jcaf/RPI-AXSenior-Tarjeta1-Motor/TARJETADEMO1/PCB1/Raspberry-Pi-3-Altium-Template-master/README.md

# Raspberry-Pi-3-Altium-Template

This Project should simplifiy the design process of modules for raspberry pi 2 and 3, model B.
It uses the 40 pin GPIO connector to access the rpi GPIOs. The dimensions of the board are based on the image below which comes from the raspberry pi developers. 

Thanks to Matheus for his feedback. The design is now tested a few times and was produced successfully.

Here is a preview on how it looks in 3D, on top of an raspberry pi.

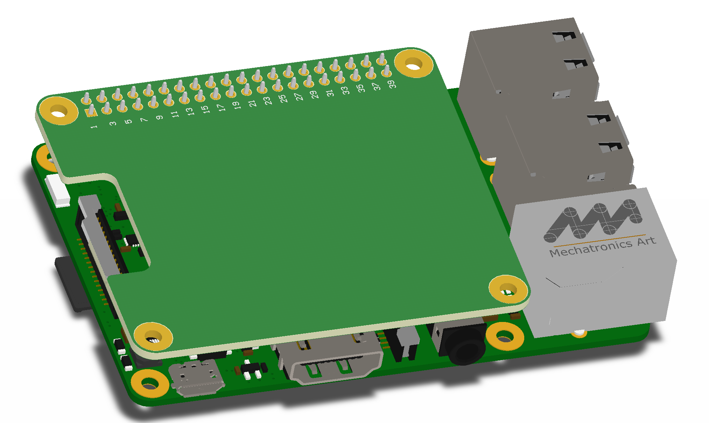
[picture p1: TARJETADEMO1/PCB1/Raspberry-Pi-3-Altium-Template-master/images/3d.png]
PCB in 3D view


The original drawing of the raspberry dimensions.

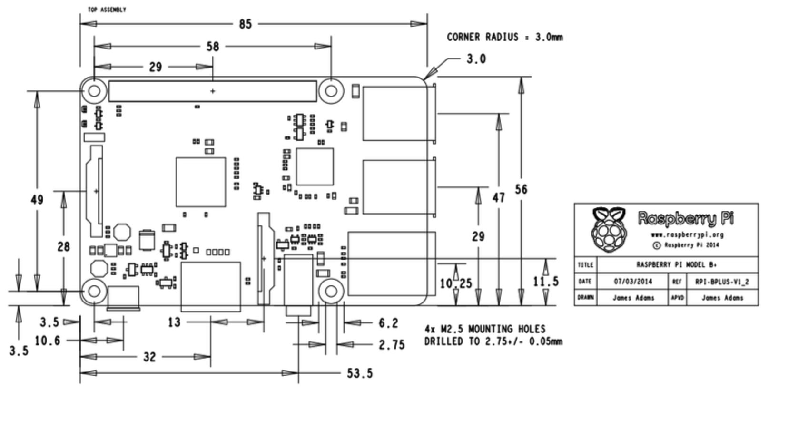
[picture p2: TARJETADEMO1/PCB1/Raspberry-Pi-3-Altium-Template-master/images/drawing1.png]
Original drawing of model B


Dimensions from template pcb, made by altiums draftsman

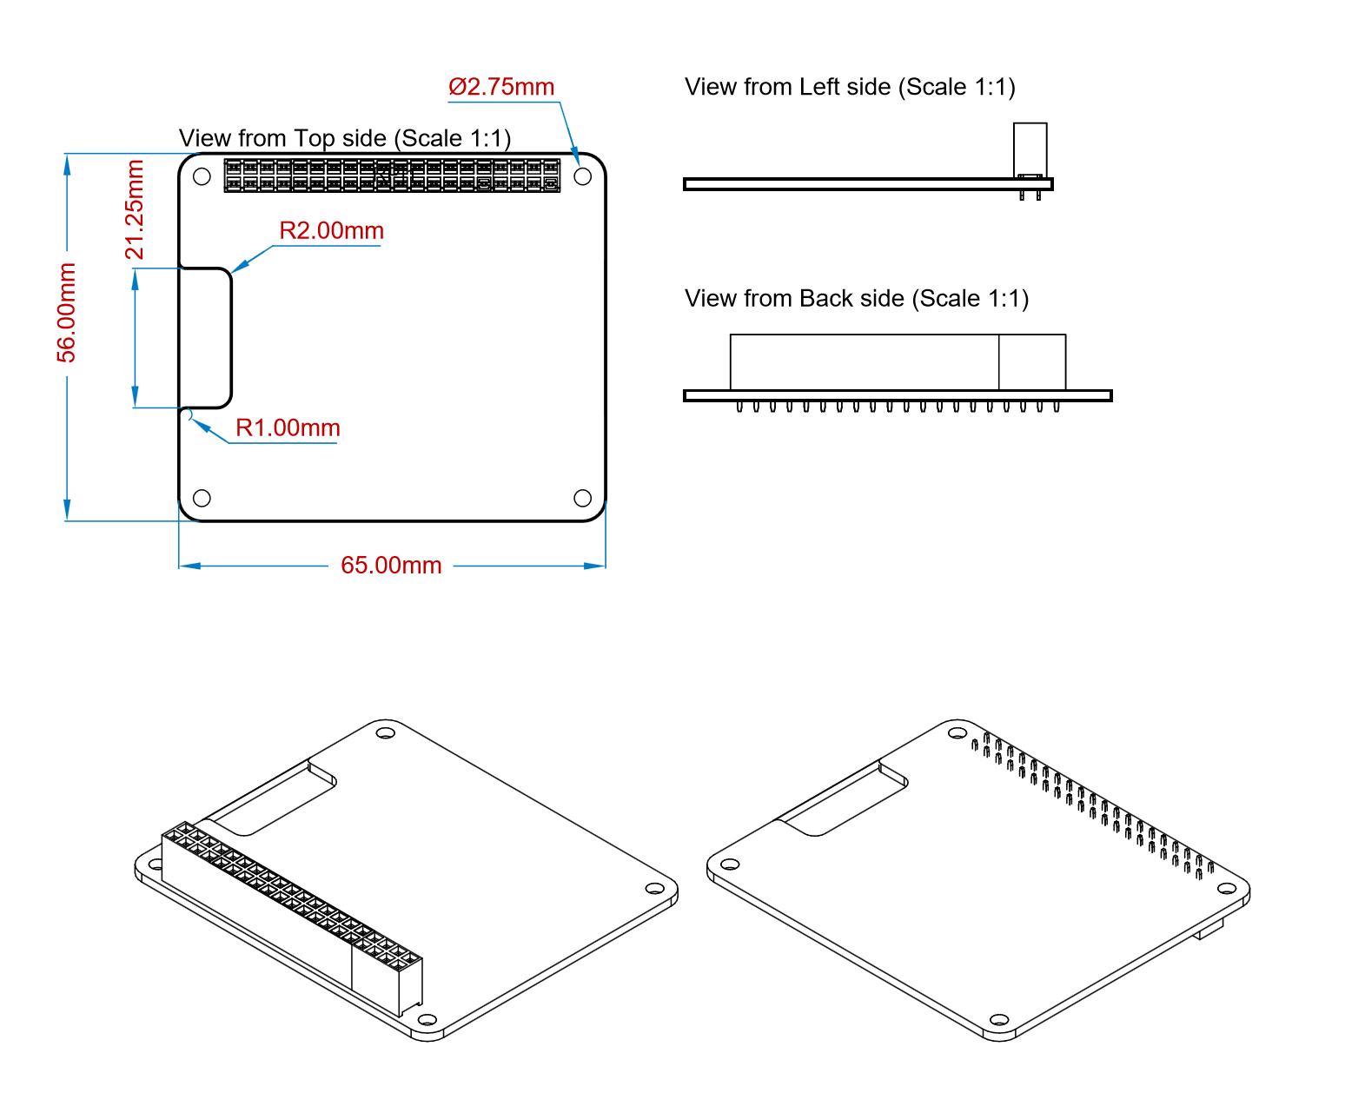
[picture p3: TARJETADEMO1/PCB1/Raspberry-Pi-3-Altium-Template-master/images/drawing2.png]
draftsman dimensioning


kindly
# Nils
