jcaf/RPI-AXSenior-Tarjeta1-Motor/TARJETADEMO1/INFO/Bi-Directional MOSFET Voltage Level Converter 3.3V to 5V_files/mosfet-level-converter-2.jpg

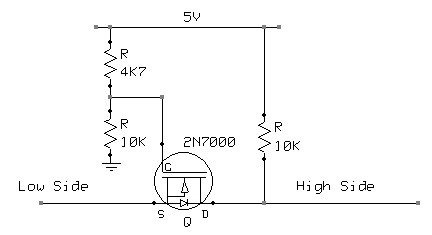
TARJETADEMO1/INFO/Bi-Directional MOSFET Voltage Level Converter 3.3V to 5V_files/mosfet-level-converter-2.jpg
