jcaf/RPI-AXSenior-Tarjeta1-Motor/TARJETADEMO1/INFO/ZMPT101B-Datasheet.jpg

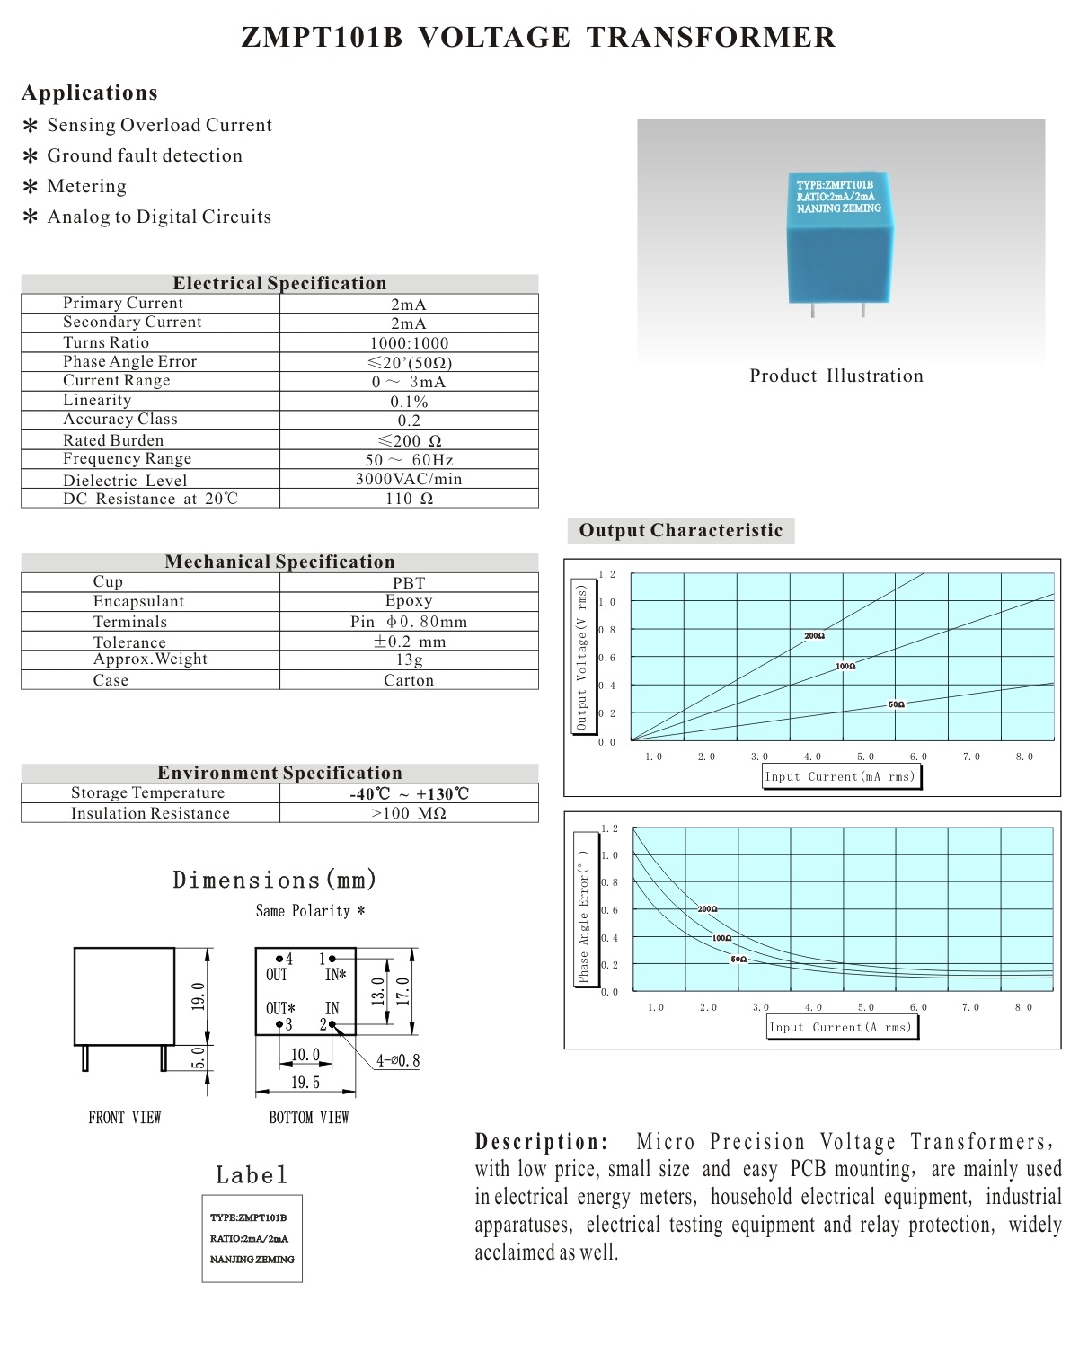
TARJETADEMO1/INFO/ZMPT101B-Datasheet.jpg
