jcaf/RPI-AXSenior-Tarjeta1-Motor/TARJETADEMO1/PCB1/Prototipo1/BOM-Prototipo1.xlsx

Comment | Description | Designator | Footprint | LibRef | Quantity
0.01uF | SMD_CHIP_CAP_CER_0603_TO_1206 | C1, C3, C5, C7 | SMD_CHIP_CAP_CER_0603_TO_1206 | SMD_CHIP_CAP_CER_0603_TO_1206 | 4
0.22uF | SMD_CHIP_CAP_CER_0603_TO_1206 | C2, C4, C6, C38 | SMD_CHIP_CAP_CER_0603_TO_1206 | SMD_CHIP_CAP_CER_0603_TO_1206 | 4
0.1uF | SMD_CHIP_CAP_CER_0603_TO_1206 | C8, C9, C10, C17, C19, C20, C21, C24, C25, C27, C28, C29, C30 | SMD_CHIP_CAP_CER_0603_TO_1206 | SMD_CHIP_CAP_CER_0603_TO_1206 | 13
68nF | 820p 1kV Y5P | C11 | Cap-Disk-D5.5-R5.08 | Cer Disc HV 820p 1kV | 1
68nF | SMD_CHIP_CAP_CER_0603_TO_1206 | C12 | SMD_CHIP_CAP_CER_0603_TO_1206 | SMD_CHIP_CAP_CER_0603_TO_1206 | 1
390nF | 820p 1kV Y5P | C13 | Cap-Disk-D5.5-R5.08 | Cer Disc HV 820p 1kV | 1
180nF | 820p 1kV Y5P | C14 | Cap-Disk-D5.5-R5.08 | Cer Disc HV 820p 1kV | 1
390nF | SMD_CHIP_CAP_CER_0603_TO_1206 | C15 | SMD_CHIP_CAP_CER_0603_TO_1206 | SMD_CHIP_CAP_CER_0603_TO_1206 | 1
180nF | SMD_CHIP_CAP_CER_0603_TO_1206 | C16 | SMD_CHIP_CAP_CER_0603_TO_1206 | SMD_CHIP_CAP_CER_0603_TO_1206 | 1
0.1uF | SMD_CHIP_CAP_CER_1206 | C18, C26 | SMD_CHIP_Cap_Cer_1206 | SMD_CHIP_CAP_CER_1206 | 2
VJ0603A150FXACW1BC |  | C22, C23 | CAPC1608X95X40ML15T15 | CMP-2006-01814-1 | 2
470uF/10V Tant. | T495X477K010ATE100 | C31 | SMD_2917 | SMD_2917 | 1
10u | 35V | C33 | El-d5-h11-F2.54 | 10u-35V | 1
1u | 35V | C34 | El-d5-h11-F2.54 | 10u-35V | 1
470uF 25V | 25V | C35, C36 | El-d8-h14-F3.81 | 470u-25V | 2
0.022uF | SMD_CHIP_CAP_CER_0603_TO_1206 | C36 | SMD_CHIP_CAP_CER_0603_TO_1206 | SMD_CHIP_CAP_CER_0603_TO_1206 | 1
470uF/25V | 25V | C37 | El-d8-h14-F3.81 | 470u-25V | 1
B550C-13-F | Schottky Barrier Rectifier , 50 V, 5 A, -55 to 150 degC, 2-Pin SMD, RoHS, Tape and Reel | D1 | DIOD-SMC-2-A_V | CMP-2000-05906-1 | 1
1N5819 | 40V 1A | D3, D4 | DO-41-300 | 1N5819 | 2
DS3231 16-SOIC | SOIC, 16-Leads, Body 10.5x7.5mm (max), Pitch 1.27mm, IPC Medium Density | DS1 | SOIC127P1030X265-16N | DS3231 | 1
RTD2-Wire-Select |  | H1 | J1x3 | H-1x3 | 1
H-1x2 |  | H2, H14 | J1x2 | H-1x2 | 2
H-1x3 |  | H3, H4, H5, H7, H8, H9, H10, H15 | J1x3 | H-1x3 | 8
H-1x6 |  | H6, H12 | J1x6 | H-1x6 | 2
H-1x4 |  | H11, H13 | J1x4 | H-1x4 | 2
MKDS 1,5 2-5,08 | PCB terminal block, nominal current: 17.5 A, nom. voltage: 400 V, pitch: 5.08 mm | H16, H17 | MKDS 1,5 2-5,08 | MKDS 1,5 2-5,08 | 2
LMV321RILT | Integrated Circuit | IC1 | SOT95P280X145-5N | LMV321RILT | 1
D Connector 9 | Receptacle Assembly, 9 Position, Right Angle | J1 | DB9-HEMBRA | D Connector 9 | 1
BLM31PG601SN1L | Chip Ferrite Bead Inductor | L1, L2 | SMD_CHIP_FERRITE_1206 | CHIP_FERRITE_BEAD_INDUCTOR_1206 | 2
FB 1206 600 ohms 100MHZ 600R 1.5A | Chip Ferrite Bead Inductor | L3 | SMD_CHIP_FERRITE_1206 | CHIP_FERRITE_BEAD_INDUCTOR_1206 | 1
33uH 3.2A 1280 | Shielded SMD Power Inductor, 33 uH, +/- 20%, -40 to 125 degC, 2-Pin SMD, RoHS, Tape and Reel | L4 | BOUR-SRR1280-2_V | CMP-2000-07148-1 | 1
Led | 5mm | LD1 | Led d5mm | Led-5mm | 1
MH Pin - 5.5Pad - 3.3drill | MH Pin - 5.5Pad - 3.3drill | MH1, MH2, MH3 | MH Pin - 5.5Pad - 3.3drill | MH Pin - 5.5Pad - 3.3drill | 3
B.desmont.2Pins | Header, 2-Pin | P1, P4, P7 | KF2EDGV/R-2P | Header 2 | 3
EspadinHembra | Header, 2-Pin | P2 | HDR1X2 | Header 2 | 1
ZMPT101B MODULE | Header, 4-Pin | P3 | ZMPT101B_MODULE | Header 4 | 1
RTD PT100 | Header, 4-Pin | P5 | KF2EDGV/R-4P | Header 4 | 1
RTD_Output | Header, 2-Pin | P6 | HDR1X2 | Header 2 | 1
Header 6 | Header, 6-Pin | P8 | KF2EDGV/R-6P | Header 6 | 1
CR2032_Holder | CR2032_Holder | PB1 | CR2032 | CR2032_Holder | 1
2N3904 | NPN General Purpose Amplifier | Q1, Q2 | TO-92A-Pitch100MILS | 2N3904 | 2
220 ohm | SMD_CHIP_RESISTOR_0603_TO_1206 | R1, R3, R4, R5 | SMD_CHIP_RESISTOR_0603_TO_1206 | SMD_CHIP_RESISTOR_0603_TO_1206 | 4
10K | SMD_CHIP_RESISTOR_0603_TO_1206 | R2, R27 | SMD_CHIP_RESISTOR_0603_TO_1206 | SMD_CHIP_RESISTOR_0603_TO_1206 | 2
1K | SMD_CHIP_RESISTOR_1206 | R6 | SMD_CHIP_RESISTOR_1206 | SMD_CHIP_RESISTOR_1206 | 1
220 ohm | SMD_CHIP_RESISTOR_1206 | R7, R33 | SMD_CHIP_RESISTOR_1206 | SMD_CHIP_RESISTOR_1206 | 2
25K | SMD_CHIP_RESISTOR_0603_TO_1206 | R8, R10, R12, R13 | SMD_CHIP_RESISTOR_0603_TO_1206 | SMD_CHIP_RESISTOR_0603_TO_1206 | 4
25K | SMD_CHIP_RESISTOR_1206 | R9 | SMD_CHIP_RESISTOR_1206 | SMD_CHIP_RESISTOR_1206 | 1
2.5K | SMD_CHIP_RESISTOR_0603_TO_1206 | R11 | SMD_CHIP_RESISTOR_0603_TO_1206 | SMD_CHIP_RESISTOR_0603_TO_1206 | 1
1K | SMD_CHIP_RESISTOR_0603_TO_1206 | R14, R22, R24, R28, R29, R31, R32, R36, R37 | SMD_CHIP_RESISTOR_0603_TO_1206 | SMD_CHIP_RESISTOR_0603_TO_1206 | 9
100K | SMD_CHIP_RESISTOR_0603_TO_1206 | R15, R16 | SMD_CHIP_RESISTOR_0603_TO_1206 | SMD_CHIP_RESISTOR_0603_TO_1206 | 2
17.4K | SMD_CHIP_RESISTOR_0603_TO_1206 | R17 | SMD_CHIP_RESISTOR_0603_TO_1206 | SMD_CHIP_RESISTOR_0603_TO_1206 | 1
107K | SMD_CHIP_RESISTOR_0603_TO_1206 | R18 | SMD_CHIP_RESISTOR_0603_TO_1206 | SMD_CHIP_RESISTOR_0603_TO_1206 | 1
49.9K | SMD_CHIP_RESISTOR_0603_TO_1206 | R19 | SMD_CHIP_RESISTOR_0603_TO_1206 | SMD_CHIP_RESISTOR_0603_TO_1206 | 1
3.09K | SMD_CHIP_RESISTOR_0603_TO_1206 | R20 | SMD_CHIP_RESISTOR_0603_TO_1206 | SMD_CHIP_RESISTOR_0603_TO_1206 | 1
20K | SMD_CHIP_RESISTOR_1206 | R21 | SMD_CHIP_RESISTOR_1206 | SMD_CHIP_RESISTOR_1206 | 1
100 Ohm | SMD_CHIP_RESISTOR_0603_TO_1206 | R23 | SMD_CHIP_RESISTOR_0603_TO_1206 | SMD_CHIP_RESISTOR_0603_TO_1206 | 1
2.2K | SMD_CHIP_RESISTOR_0603_TO_1206 | R25, R26 | SMD_CHIP_RESISTOR_0603_TO_1206 | SMD_CHIP_RESISTOR_0603_TO_1206 | 2
2K | SMD_CHIP_RESISTOR_0603_TO_1206 | R30 | SMD_CHIP_RESISTOR_0603_TO_1206 | SMD_CHIP_RESISTOR_0603_TO_1206 | 1
1 Ohm | 0.25W 5% 250V | R34, R35 | R0.25-400 | R-0.25W | 2
RAS | AC-120V 15A DC-14V 20A 30V 15A /0.36W | RA1, RA2 | Rele RAS | Relay RAS | 2
RPI GPIO Connector | GPIO Header for Raspberry Pi A+/B+/Pi 2/Pi 3 - 2x20 | RPI1 | rpi | rpi connector | 1
ADS1115IDGST | 16-Bit ADC with Integrated Multiplexer, PGA, Comparator, Oscillator, and Reference, -40 to 125 degC, 10-pin SOP (DGS10), Green (RoHS & no Sb/Br) | U1 | TI-DGS10_L | CMP-0003-00378-2 | 1
LMV324IDR | Quad Low-Voltage Rail-to-Rail Output Operational Amplifier, 2.7 to 5.5 V, -40 to 125 degC, 14-Pin SOIC (D), Green (RoHS & no Sb/Br), Tape and Reel | U2 | D0014A_V | CMP-1685-00010-1 | 1
LM385Z-2.5/NOPB | Micropower Voltage Reference Diode, 3-pin TO-92, Pb-Free | U3 | Z03A | CMP-0074-00017-2 | 1
ATmega328P-PU | 8-bit AVR Microcontroller, 32KB Flash, 1KB EEPROM, 2KB SRAM, 28-pin PDIP, Industrial Grade (-40°C to 85°C) | U4 | 28P3 | CMP-0095-00013-2 | 1
MAX3232CSE+T | Low-Power, True RS-232 Transceivers Using Four 0.1 uF External Capacitor, up to 1 Mbps, 3.0 to 5.5 V, 0 to 70 degC, 16-Pin SOIC (S16+1), RoHS, Tape and Reel | U5 | MAXM-S16+1_M | CMP-2000-06662-1 | 1
7805 |  | U6 | TO 220_DISIPADOR_HORIZONTAL_2 | 7805 | 1
LM2596S-5.0/NOPB | SIMPLE SWITCHER® Power Converter 150 KHz 3A Step-Down Voltage Regulator, 5-pin TO-263, Pb-Free | U7 | KTT0005B_M | CMP-0069-00269-3 | 1
CRYSTAL_PTH_16MHz | CRYSTAL_PTH_16MHz | Y1 | Crystal PTH HC49LT, THT, 16MHz | CRYSTAL_PTH_16MHz | 1
