jcaf/RPI-AXSenior-Tarjeta1-Motor/TARJETADEMO1/INFO/Problems with a two-diode 3.3V -> 5V level shifting circuit - Electrical Engineering Stack Exchange_files/6oxsM.png

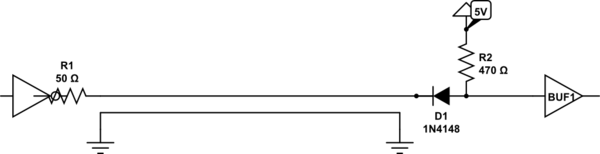
TARJETADEMO1/INFO/Problems with a two-diode 3.3V -> 5V level shifting circuit - Electrical Engineering Stack Exchange_files/6oxsM.png
