jcaf/RPI-AXSenior-Tarjeta1-Motor/TARJETADEMO1/PCB1/Prototipo1/Artes-Serigrafia/bottom solder.pdf

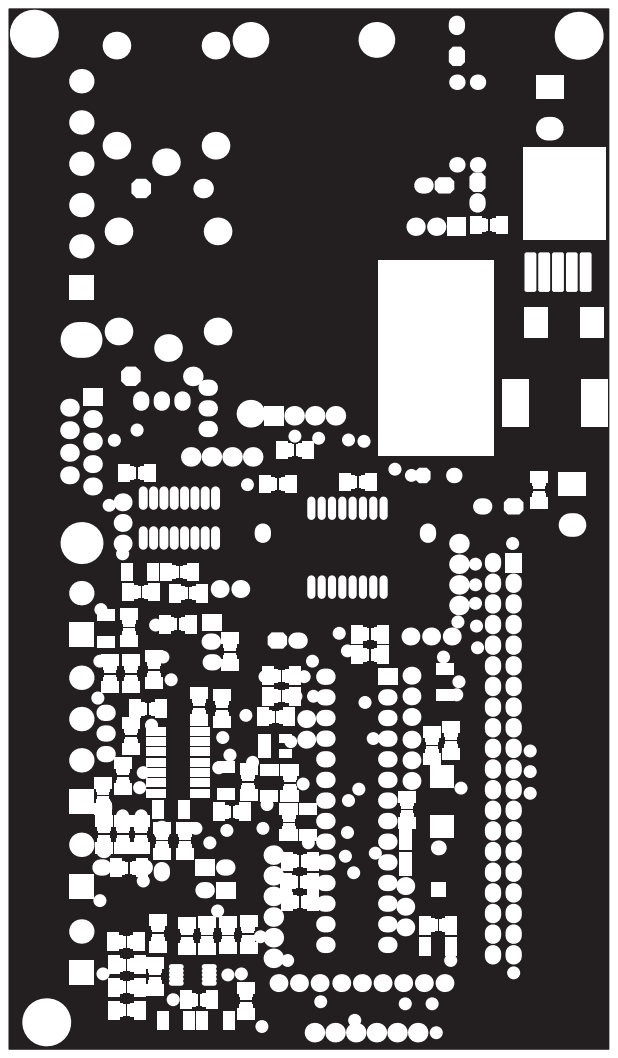
[picture p18: page 1]
