jcaf/RPI-AXSenior-Tarjeta1-Motor/TARJETADEMO1/PCB1/Prototipo1/Artes-Serigrafia/top solder.pdf

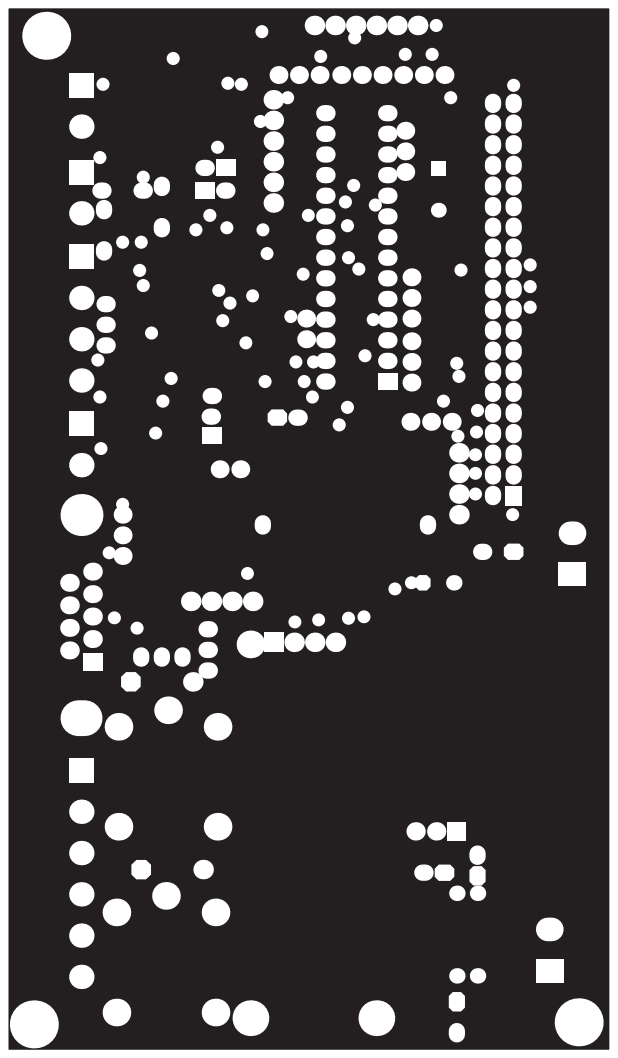
[picture p19: page 1]
