jcaf/RPI-AXSenior-Tarjeta1-Motor/TARJETADEMO1/PCB1/Prototipo1/Artes-Serigrafia/bottom layer.pdf

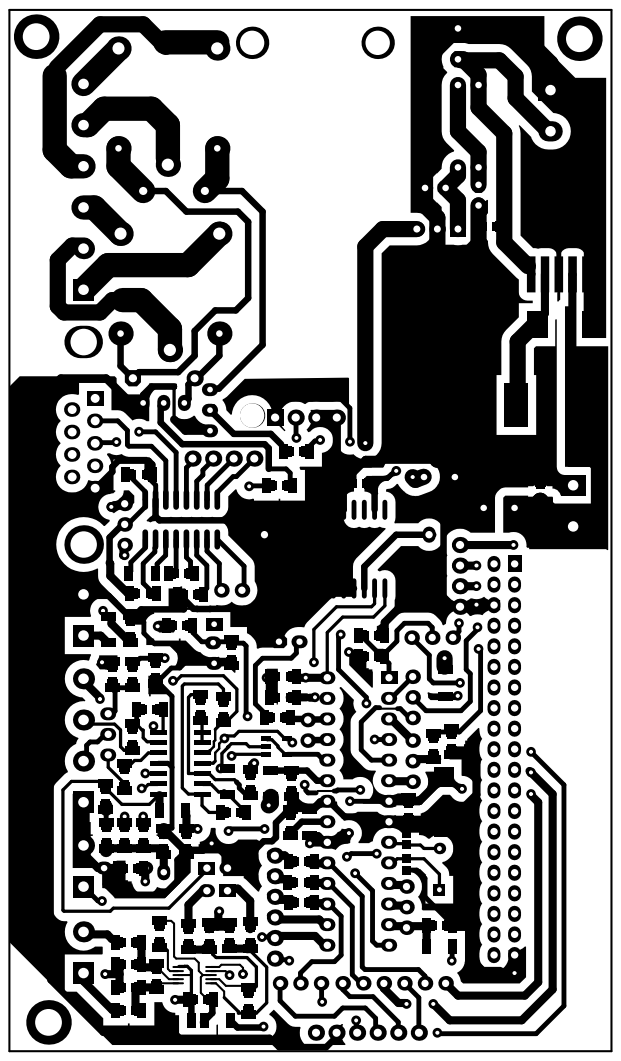
[picture p20: page 1]
