jcaf/RPI-AXSenior-Tarjeta1-Motor/TARJETADEMO1/PCB1/Prototipo1/Artes-Serigrafia/bottom overlay.pdf

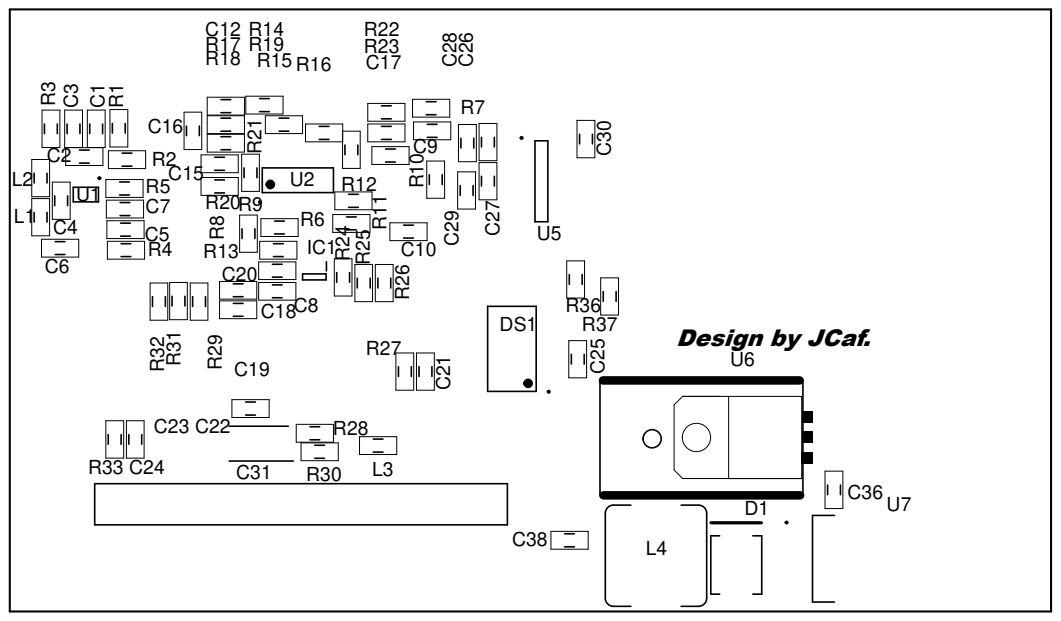
[picture p21: page 1]
