jcaf/RPI-AXSenior-Tarjeta1-Motor/TARJETADEMO1/PCB1/Prototipo1/Artes-Serigrafia/top layer.pdf

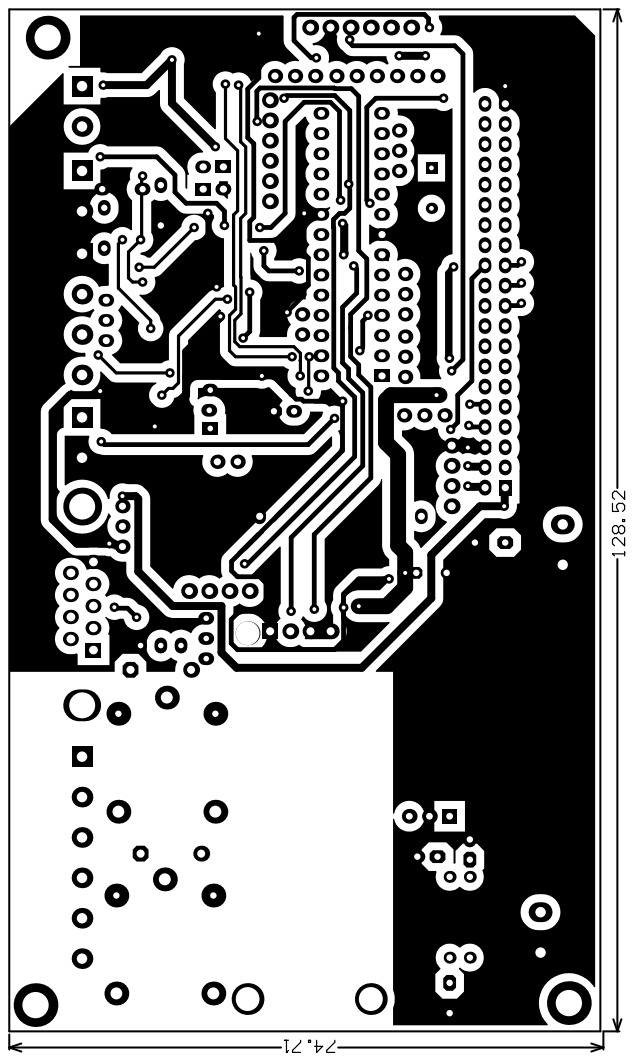
[picture p22: page 1]
