jcaf/RPI-AXSenior-Tarjeta1-Motor/(list of files, drawings)

Other design files:
TARJETADEMO1/PCB1/Prototipo1/MAX3232.SchDoc
TARJETADEMO1/PCB1/Prototipo1/PowerSupply.SchDoc
TARJETADEMO1/PCB1/Prototipo1/Prototipo1.PrjPcb
TARJETADEMO1/PCB1/Prototipo1/Relay.SchDoc
TARJETADEMO1/PCB1/Prototipo1/Sensores.SchDoc
TARJETADEMO1/PCB1/Prototipo1/SensorTemperatura.SchDoc
TARJETADEMO1/PCB1/Prototipo1/uController.SchDoc
TARJETADEMO1/PCB1/Raspberry-Pi-3-Altium-Template-master/RPI 3.PcbDoc
TARJETADEMO1/PCB1/Raspberry-Pi-3-Altium-Template-master/RPI 3.SchDoc
TARJETADEMO1/PCB1/Raspberry-Pi-3-Altium-Template-master/RPI GPIO BOARD.PrjPcb
