jcaf/RPI-AXSenior-Tarjeta1-Motor/TARJETADEMO1/FIRMWARE1/iot-hub-c-raspberrypi-client-app/config.h

/*
* IoT Hub Raspberry Pi C - Microsoft Sample Code - Copyright (c) 2017 - Licensed MIT
*/

#ifndef CONFIG_H_
#define CONFIG_H_

#define INTERVAL 2000
#define SIMULATED_DATA 0
#define BUFFER_SIZE 256

#define LED_PIN 7

#define CREDENTIAL_PATH "~/.iot-hub"

#endif  // CONFIG_H_
