jcaf/RPI-AXSenior-Tarjeta1-Motor/TARJETADEMO1/FIRMWARE1/Atmega/SoftwareSerial_v1/AxSenior_IotBoard_1/i2c/I2CCommonFx.h

#ifndef I2CCOMMONFX_H_
#define I2CCOMMONFX_H_

#include "../types.h"
void I2Ccfx_Write1Byte(byte SLAVE_ADDRESS, byte START_ADDRESS, byte DATA);
void I2Ccfx_WriteArray(byte SLAVE_ADDRESS, byte START_ADDRESS, volatile byte *pDATA, byte NUMBYTES_TOWRITE);
void I2Ccfx_ReadRegistersAtAddress(byte SLAVE_ADDRESS, byte START_ADDRESS, volatile byte * pDATA, byte NUMBYTES_TOREAD);


#endif
