jcaf/RPI-AXSenior-Tarjeta1-Motor/TARJETADEMO1/FIRMWARE1/Atmega/SoftwareSerial_v1/AxSenior_IotBoard_1/temperatura.c

#include "system.h"
#include "main.h"
#include "adc/adc.h"

#define Vdc5 4.87

float temperature;

//float R1 = 218.5;//ohms
float R1 = 1000;//ohms

float in[] = { 100.00, 100.39, 100.78, 101.17, 101.56, 101.95, 102.34, 102.73, 103.12, 103.51,
               103.90, 104.29, 104.68, 105.07, 105.46, 105.85, 106.24, 106.63, 107.02, 107.40,
               107.79, 108.18, 108.57, 108.96, 109.35, 109.73, 110.12, 110.51, 110.90, 111.29,
               111.67, 112.06, 112.45, 112.83, 113.22, 113.61, 114.00, 114.38, 114.77, 115.15,
               115.54, 115.93, 116.31, 116.70, 117.08, 117.47, 117.86, 118.24, 118.63, 119.01,
               119.40, 119.78, 120.17, 120.55, 120.94, 121.32, 121.71, 122.09, 122.47, 122.86,
               123.24, 123.63, 124.01, 124.39, 124.78, 125.16, 125.54, 125.93, 126.31, 126.69,
               127.08, 127.46, 127.84, 128.22, 128.61, 128.99, 129.37, 129.75, 130.13, 130.52
             };

float MultiMap(float val, float* _in, uint8_t size)
{
    // calculate if value is out of range
    if (val < _in[0] )
        return -99.99;
    if (val > _in[size - 1] )
        return 99.99;

    //  search for 'value' in _in array to get the position No.
    uint8_t pos = 0;
    while (val > _in[pos])
        pos++;

    // handles the 'rare' equality case
    if (val == _in[pos])
        return pos;

    float r1 = _in[pos - 1];
    float r2 = _in[pos];
    int c1 = pos - 1;
    int c2 = pos;

    return c1 + (val - r1) / (r2 - r1) * (c2 - c1);
}

float T = 0;
void temp_process(void)
{
    static int i;
    //ADC_set_channel(ADC_CH_1);
    //for (int i = 0; i < 2000; i++)
    {
        int pt100 = ADC_read(ADC_CH_1);//analogRead(A0);
        float Vout = pt100 * (Vdc5 / 1023.0);
        float R2 = (R1 * Vout) / (Vdc5 - Vout);
//        R2 -= 3; //offset

        float c =  MultiMap(R2, in, 80);
        T += c;
    }
    if (++i >= 2000)
    {
        T /= 2000;

        //temperature = T;
        temperature = T + 5.4;//correction

        //
        i = 0x00;
        T = 0x00;
    }

}
