jcaf/RPI-AXSenior-Tarjeta1-Motor/TARJETADEMO1/FIRMWARE1/Atmega/SoftwareSerial_v1/AxSenior_IotBoard_1/rpm.h

#ifndef RPM_H_
#define RPM_H_

    #define DDRxINT0    (DDRD)
    #define PORTWxINT0	(PORTD)
    #define PORTRxINT0	(PIND)
    #define PIN_INT0 	(2)

    extern volatile uint16_t rpm_ISR;
    extern uint16_t RPM;

    void RPM_process(void);

#endif // RPM_H_
