jcaf/RPI-AXSenior-Tarjeta1-Motor/TARJETADEMO1/FIRMWARE1/Atmega/SoftwareSerial_v1/AxSenior_IotBoard_1/types.h

#ifndef TYPES_H_
#define TYPES_H_
#include <stdint.h>

typedef uint8_t(*PTRFX_retUINT8_T)(void);
typedef uint16_t(*PTRFX_retUINT16_T)(void);
typedef void (*PTRFX_retVOID)(void);
typedef void (*PTRFX_retVOID_arg1_UINT8_T)(uint8_t);
typedef void (*PTRFX_retVOID_arg1_INT8_T)(int8_t);
typedef void (*PTRFX_retVOID_arg1_PCHAR)(char *);
typedef unsigned char BOOL;
typedef unsigned char byte;

#endif // TYPES_H_
