jcaf/RPI-AXSenior-Tarjeta1-Motor/TARJETADEMO1/FIRMWARE1/iot-hub-c-raspberrypi-client-app/wiring.h

/*
* IoT Hub Raspberry Pi C - Microsoft Sample Code - Copyright (c) 2017 - Licensed MIT
*/

#ifndef WIRING_H_
#define WIRING_H_

#include <stdio.h>
#include <stdlib.h>
#include <wiringPi.h>
#include <wiringPiSPI.h>

#include "./config.h"

#define WIRINGPI_SETUP 1

#if !SIMULATED_DATA
#include "./bme280.h"

#define SPI_CHANNEL 0
#define SPI_CLOCK 1000000L

#define SPI_SETUP 1 << 2
#define BME_INIT 1 << 3
#endif

#define TEMPERATURE_ALERT 30

int readMessage(int messageId, char *payload);
void blinkLED();
void setupWiring();

#endif  // WIRING_H_
