jcaf/RPI-AXSenior-Tarjeta1-Motor/(commit log)

2020-02-17 3ra Entrega - preview PCB tarjeta1
    [MAX3232.SchDoc, PowerSupply.SchDoc, Prototipo1.PrjPcb, RATIOMETRIC VOLTAGE DIVIDER CALCULATOR AND GRAPH.xls, RPI 3.PcbDoc, RPI 3.SchDoc, RPI GPIO BOARD.PrjPcb, Relay.SchDoc]
2020-02-19 PCB FINALIZADA
    [BOM-Prototipo1.xlsx, MAX3232.SchDoc, PowerSupply.SchDoc, Prototipo1.PrjPcb, Relay.SchDoc, SensorTemperatura.SchDoc, Sensores.SchDoc, uController.SchDoc]
2020-02-23 integrando DS3231 + Nueva tarjeta finalizada
    [Prototipo1.PrjPcb, SensorTemperatura.SchDoc, Sensores.SchDoc]
